asumo-1xts/J2J/docs/README.md

<h1 align="center">

Just the Two of ~~US~~ JIS

</h1>

<div align="center">






**_We can make it if we try ..._**

製作記を公開しました: https://blog.asumo.dev/posts/16-J2J.html

<br/>

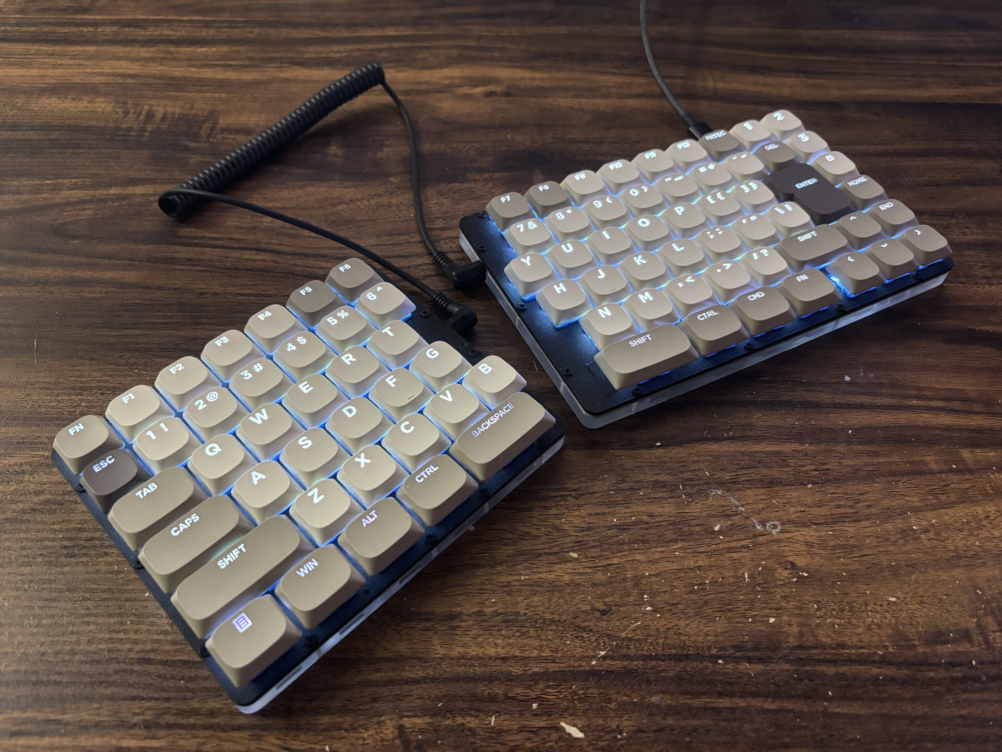
[picture p1: docs/01.webp]
完成品


</div>

## Spec

| 項目 | 仕様 |
| --- | --- |
| 接続・給電 | USB Type-C |
| レイアウト | ロープロファイル<br/>**JIS-like US** 87キー |
| キーマップ変更  | ✅ - [Vial](https://get.vial.today/) |
| ホットスワップ  | ✅ |
| LEDライティング | ✅ |

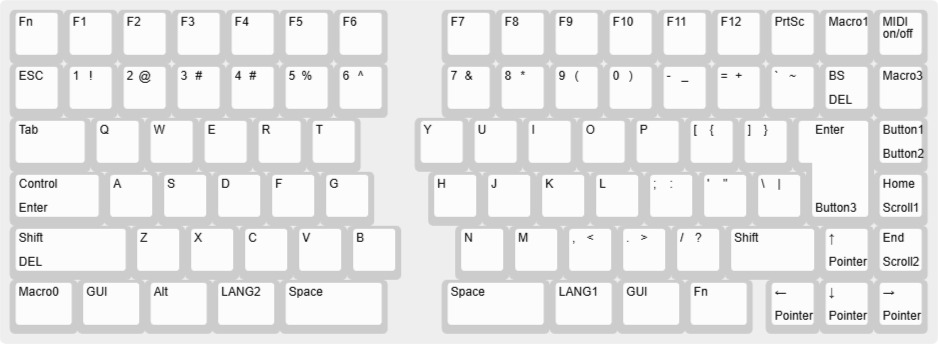
[picture p2: docs/keyboard-layout.jpg]
Keyboard Layout


## BOM

| 部品 | 数量 |
| --- | ---: |
| PCB基板 | 左右1組 |
| Kailh Choc V2 キースイッチ | 87個 |
| Kailh Choc V2 HotSwapソケット  | 87個 |
| SK6812MINI-E フルカラーLED | 87個 |
| ケース | 左右上下1組 |
| M2 10mmタップねじ | 42本 |
| ロープロファイル用キーキャップ | 1組 |
| 3.5mm TRRSケーブル | 1本 |
| USB Type-Cケーブル | 1本 |

## Notice

- 故障を避けるため、TRRSケーブルの着脱はUSB Type-Cケーブルを抜いた状態で行ってください。
- コンパイルの際は、Vial-QMKリポジトリのソースファイルを手元で編集する必要があります。<br>詳細: https://blog.asumo.dev/posts/16-J2J.html#ファームウェア
