asumo-1xts/J2J/J2J_ASM.FCStd

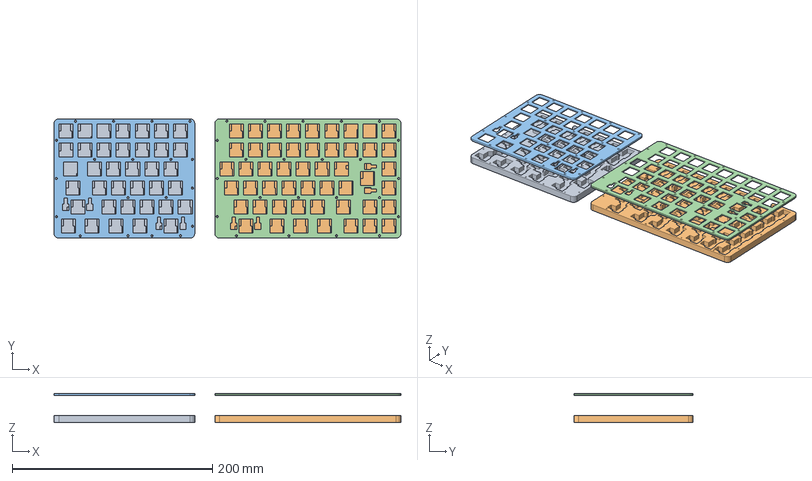
[picture p3: CAD file, 2026-06-14]
J2J_ASM.FCStd
346.2 x 119.1 x 29.4 mm
