asumo-1xts/J2J/(commit log)

2026-05-30 docs: Add docs
    [keyboard-matrix.csv]
2026-05-30 feat: Add KiCad files for PCB
    [J2J_PCB_L.kicad_pcb, J2J_PCB_L.kicad_sch, J2J_PCB_R.kicad_pcb, J2J_PCB_R.kicad_sch]
2026-05-30 feat: Add KiCad files for case
    [J2J_PARTS_ASM.FCStd, J2J_PLATE_BOTTOM_L.kicad_pcb, J2J_PLATE_BOTTOM_R.kicad_pcb, J2J_PLATE_TOP_L.kicad_pcb, J2J_PLATE_TOP_R.kicad_pcb, J2J_SPACER_BOTTOM_L.kicad_pcb, J2J_SPACER_BOTTOM_R.kicad_pcb, J2J_SPACER_TOP_L.kicad_pcb]
2026-06-04 feat: `LGUI`と`LALT`を入れ替え
2026-06-14 fix: スタビライザー周りの干渉を修正
    [J2J_ASM.FCStd, J2J_PARTS_ASM.FCStd, J2J_PCB_L.kicad_pcb, J2J_SPACER_TOP_L.kicad_pcb, J2J_SPACER_TOP_R.kicad_pcb]
2026-06-14 feat: 起動時のLEDアニメーションを実装
2026-06-14 feat: スリープ時のLED消灯を実装
2026-06-14 refactor: ヘッダーを編集すれば済むよう分割
2026-06-17 refactor: 記述順を入れ替え
2026-06-17 feat: マウスキーを追加
2026-06-18 build: atmega32u4用に設定を更新
2026-06-18 perf: TAP機能を強引に削除
2026-06-18 feat: MIDI機能を追加
2026-06-18 feat: キーマップの追加と編集
2026-06-18 feat: LEDアニメーションの切り替わりを実装
2026-07-04 fix: キーマトリクスの抜け部分を修正
2026-07-04 style: インデントをフォーマット
2026-07-04 perf: スリープ機能を削除
2026-07-04 feat: キーマップを変更
2026-07-20 docs: バグに先回りして回避策を付記
2026-07-20 feat: RGBライトは点けっぱなし
