asumo-1xts/J2J/(notices)

Notices in the files:
docs/README.md:
License: GPL-3.0
